donjoergo/bobbycar/test/Bobby_Car_Controller_Bkp/README.md

Here the Arduino code for the high level Bobby Car Controller can be found.

The Controller has the following features:
- TODO Add features here ;)
