donjoergo/bobbycar/(commit log)

2024-10-14 Copying hoverboard firmware
    [ODrive motor guide.xlsx]
2024-10-14 Initially adding untested arduino code generated from ChatGPT
2025-08-03 Add Nunchuk pinout schematic for wiring reference
2025-08-11 Update README.md to add current features section and additional image
2026-02-19 refactor: remove hoverboard firmware (now extra fork repo)
    [ODrive motor guide.xlsx]
2026-02-19 docs: Update README with BMS details
2026-02-19 docs: add todo points for new battery pack
2026-02-23 docs: added bms image
2026-02-28 fix(controller): harden nunchuk input handling and cppcheck issues
    [main.cpp, nunchuk.h]
2026-03-02 refactor(controller): document and simplify main control flow
2026-09-24 chore: remove debug print
2026-09-24 feat(controller): coast down to throttle set speed
